jehyunghan0777-lab/motion-aware-hr-monitor/hardware/images/example.jpg

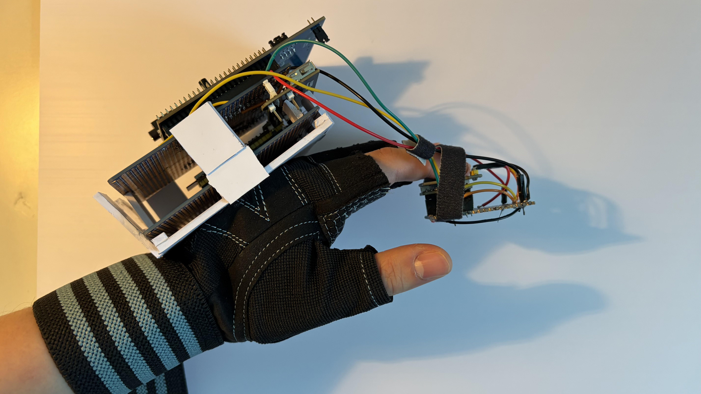
hardware/images/example.jpg
