jehyunghan0777-lab/motion-aware-hr-monitor/hardware/images/first_layer.jpeg

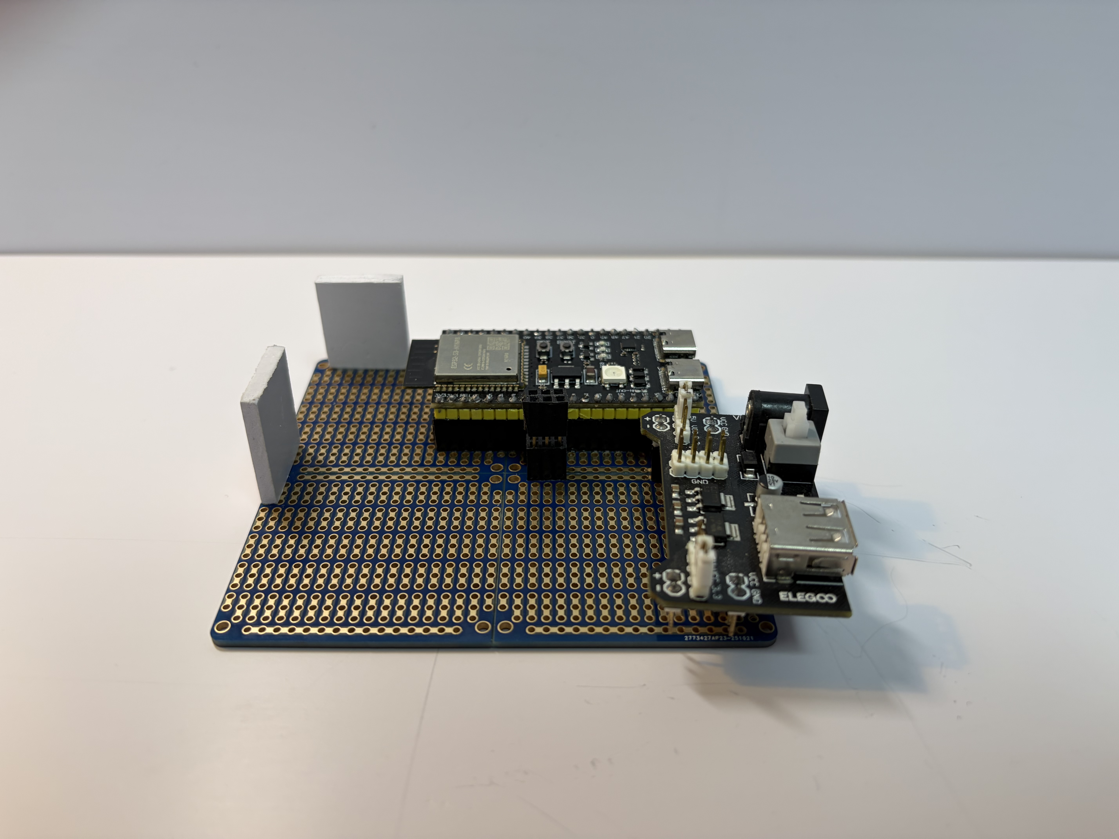
hardware/images/first_layer.jpeg
