jehyunghan0777-lab/motion-aware-hr-monitor/hardware/images/glove_based_platform.jpeg

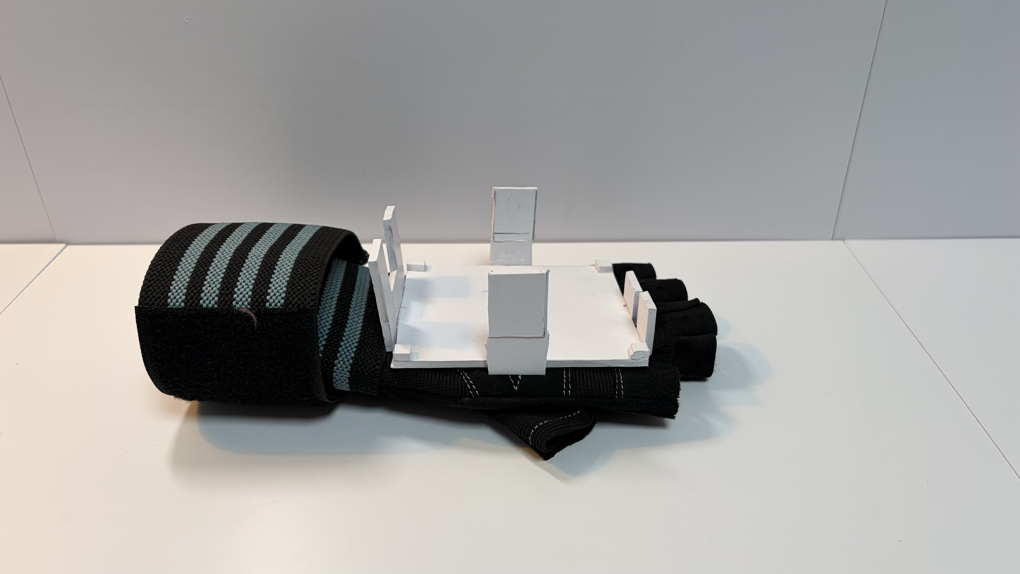
hardware/images/glove_based_platform.jpeg
