jehyunghan0777-lab/motion-aware-hr-monitor/hardware/images/sensors.jpeg

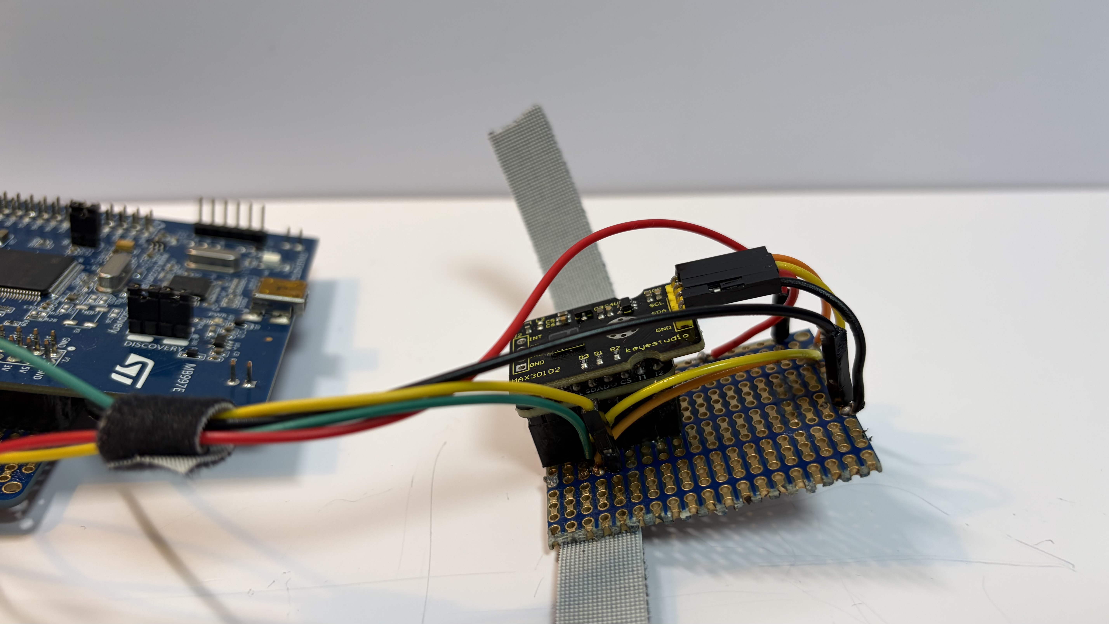
hardware/images/sensors.jpeg
