jehyunghan0777-lab/motion-aware-hr-monitor/hardware/images/two_layers_stacked.jpeg

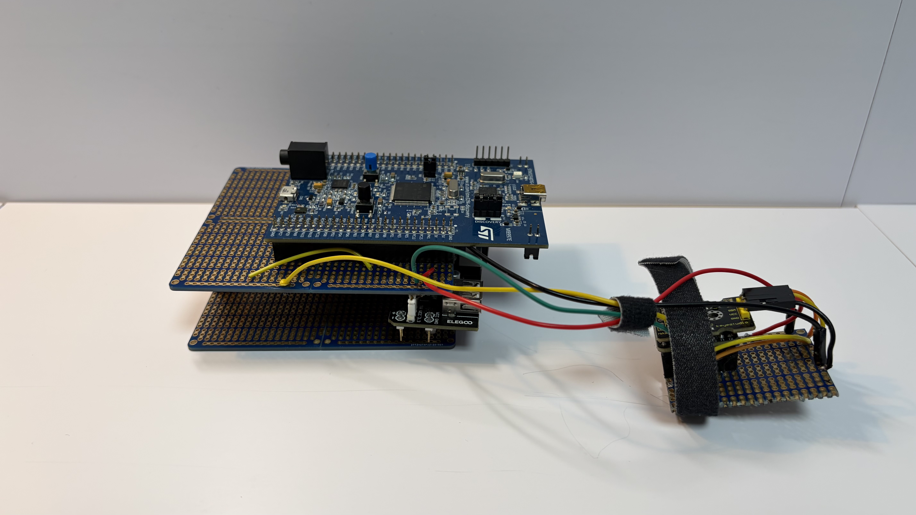
hardware/images/two_layers_stacked.jpeg
