jehyunghan0777-lab/motion-aware-hr-monitor/hardware/schematic/schematic_motion_aware_hr_monitor.png

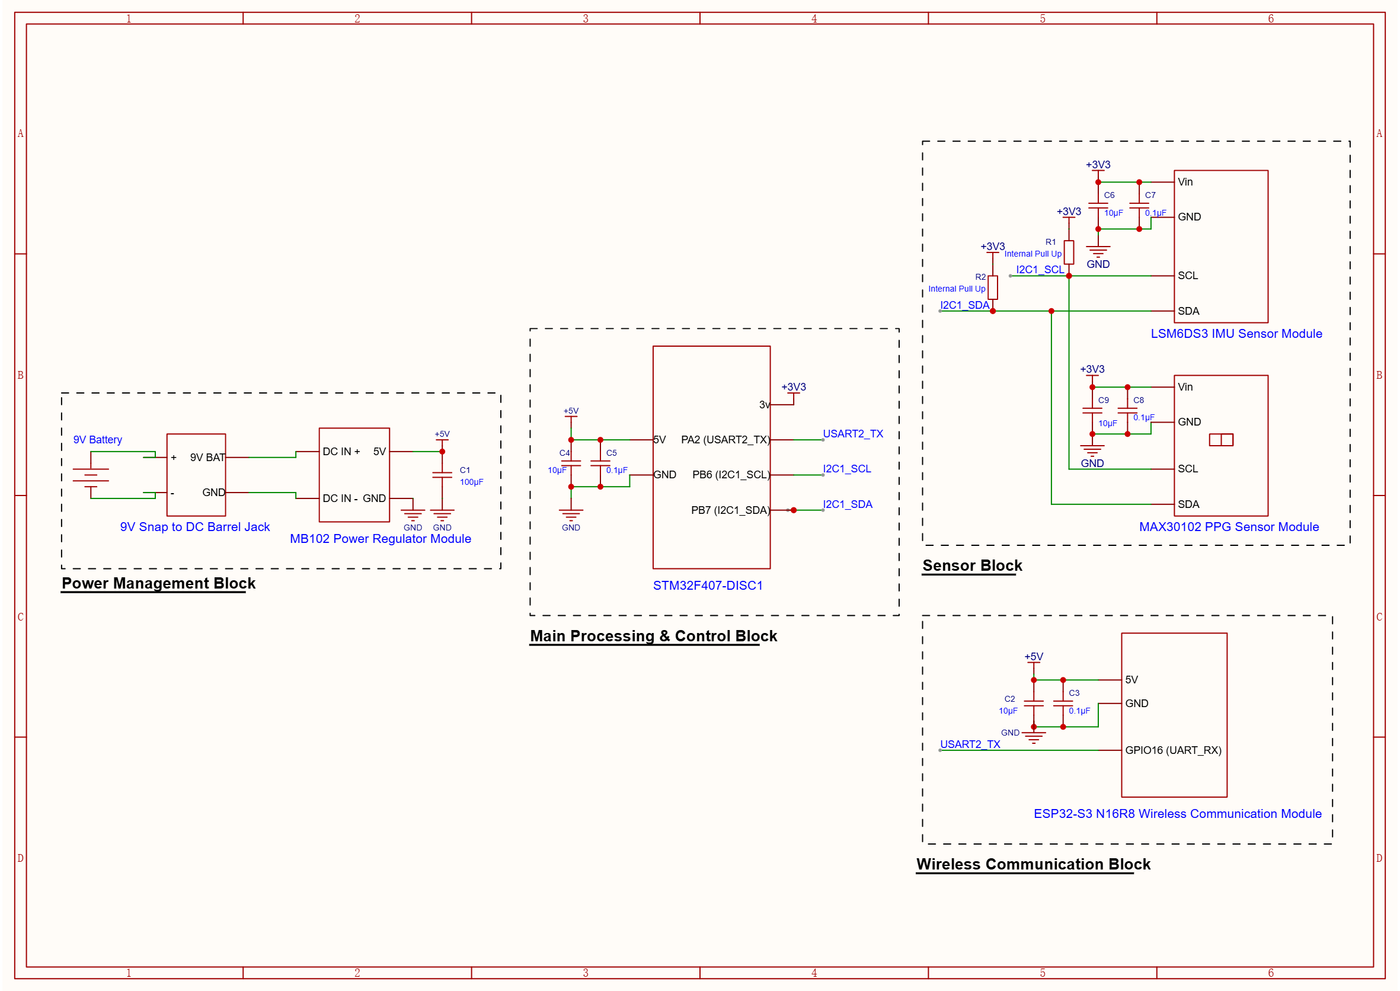
hardware/schematic/schematic_motion_aware_hr_monitor.png
