jehyunghan0777-lab/motion-aware-hr-monitor/data/results/hr_logger_1hz_analysis.xlsx

Sheet: Data
seconds | hr_fft | conf_fft | peak_hz | peak_ratio | k_peaks | hr_final | conf_final | mode | s_motion | s_freq | motion_high | freq_bad | motion | external_hr | error_bpm | abs_error_bpm
0 | 86.000 | 0.710 | 1.444 | 2.340 | 7.000 | 86.000 | 0.550 | FREQ | 0.900 | 0.550 | 1.000 | 0.000 | 1019.500 | 86.000 | 0.000 | 0.000
1 | 85.200 | 0.670 | 1.390 | 2.210 | 7.000 | 85.200 | 0.530 | FREQ | 0.900 | 0.530 | 1.000 | 0.000 | 1012.500 | 86.000 | -0.800 | 0.800
2 | 82.100 | 0.410 | 1.270 | 1.830 | 7.000 | 82.100 | 0.410 | FREQ | 0.920 | 0.410 | 1.000 | 0.000 | 768.200 | 86.000 | -3.900 | 3.900
3 | 82.100 | 0.670 | 1.272 | 2.190 | 7.000 | 82.100 | 0.620 | FREQ | 0.890 | 0.620 | 1.000 | 0.000 | 1103.000 | 86.000 | -3.900 | 3.900
4 | 80.100 | 0.690 | 1.297 | 2.260 | 7.000 | 80.100 | 0.690 | FREQ | 0.920 | 0.690 | 1.000 | 0.000 | 787.600 | 86.000 | -5.900 | 5.900
5 | 79.400 | 0.720 | 1.307 | 2.380 | 7.000 | 79.400 | 0.720 | FREQ | 0.910 | 0.720 | 1.000 | 0.000 | 940.300 | 82.000 | -2.600 | 2.600
6 | 78.500 | 0.740 | 1.283 | 2.440 | 7.000 | 78.500 | 0.730 | FREQ | 0.920 | 0.730 | 1.000 | 0.000 | 812.600 | 82.000 | -3.500 | 3.500
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
