jehyunghan0777-lab/motion-aware-hr-monitor/data/results/hr_logger_2hz_analysis.xlsx

Sheet: Data
seconds | hr_fft | conf_fft | peak_hz | peak_ratio | k_peaks | hr_final | conf_final | mode | s_motion | s_freq | motion_high | freq_bad | motion | external_hr | error_bpm | abs_error_bpm
0.000 | 78.000 | 0.780 | 1.351 | 2.560 | 7.000 | 78.000 | 0.540 | FREQ | 0.270 | 0.540 | 1.000 | 0.000 | 7265.200 | 81.000 | -3.000 | 3.000
1.000 | 79.300 | 0.860 | 1.351 | 2.820 | 7.000 | 79.300 | 0.600 | FREQ | 0.240 | 0.600 | 1.000 | 0.000 | 7588.400 | 81.000 | -1.700 | 1.700
2.000 | 80.000 | 0.930 | 1.346 | 3.060 | 7.000 | 80.000 | 0.680 | FREQ | 0.280 | 0.680 | 1.000 | 0.000 | 7230.400 | 81.000 | -1.000 | 1.000
3.000 | 80.300 | 0.910 | 1.343 | 3.010 | 7.000 | 80.300 | 0.690 | FREQ | 0.330 | 0.690 | 1.000 | 0.000 | 6741.400 | 81.000 | -0.700 | 0.700
4.000 | 80.300 | 0.810 | 1.341 | 2.660 | 7.000 | 80.300 | 0.590 | FREQ | 0.220 | 0.590 | 1.000 | 0.000 | 7790.100 | 81.000 | -0.700 | 0.700
5.000 | 80.700 | 0.800 | 1.355 | 2.620 | 7.000 | 80.700 | 0.790 | FREQ | 0.270 | 0.790 | 1.000 | 0.000 | 7285.800 | 84.000 | -3.300 | 3.300
6.000 | 81.800 | 0.770 | 1.396 | 2.550 | 7.000 | 81.800 | 0.740 | FREQ | 0.170 | 0.740 | 1.000 | 0.000 | 8304.100 | 84.000 | -2.200 | 2.200
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
