jehyunghan0777-lab/motion-aware-hr-monitor/data/results/hr_logger_3hz_analysis.xlsx

Sheet: Data
seconds | hr_fft | conf_fft | peak_hz | peak_ratio | k_peaks | hr_final | conf_final | mode | s_motion | s_freq | motion_high | freq_bad | motion | external_hr | error_bpm | abs_error_bpm
0.000 | 82.300 | 0.730 | 1.381 | 2.410 | 7.000 | 82.300 | 0.730 | FREQ | 0.000 | 0.730 | 1.000 | 0.000 | 10140.200 | 83.000 | -0.700 | 0.700
1.000 | 82.700 | 0.800 | 1.390 | 2.640 | 7.000 | 82.700 | 0.690 | FREQ | 0.040 | 0.690 | 1.000 | 0.000 | 9577.400 | 83.000 | -0.300 | 0.300
2.000 | 83.700 | 0.780 | 1.425 | 2.560 | 7.000 | 83.700 | 0.680 | FREQ | 0.000 | 0.680 | 1.000 | 0.000 | 10208.400 | 85.000 | -1.300 | 1.300
3.000 | 85.000 | 0.820 | 1.450 | 2.710 | 7.000 | 85.000 | 0.790 | FREQ | 0.010 | 0.790 | 1.000 | 0.000 | 9897.100 | 85.000 | 0.000 | 0.000
4.000 | 86.200 | 0.540 | 1.465 | 2.250 | 7.000 | 86.200 | 0.510 | FREQ | 0.180 | 0.510 | 1.000 | 0.000 | 8232.600 | 86.000 | 0.200 | 0.200
5.000 | 86.600 | 0.400 | 1.465 | 1.800 | 7.000 | 86.600 | 0.330 | FREQ | 0.180 | 0.330 | 1.000 | 0.000 | 8219.400 | 86.000 | 0.600 | 0.600
6.000 | 86.600 | 0.380 | 1.465 | 1.730 | 7.000 | 86.600 | 0.320 | FREQ | 0.130 | 0.320 | 1.000 | 0.000 | 8705.800 | 88.000 | -1.400 | 1.400
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
