jehyunghan0777-lab/motion-aware-hr-monitor/data/results/hr_logger_no_motion_analysis.xlsx

Sheet: Data
seconds | hr_fft | conf_fft | peak_hz | peak_ratio | k_peaks | hr_final | conf_final | mode | s_motion | s_freq | motion_high | freq_bad | motion | external_hr | error_bpm | abs_error_bpm
0 | 88.7 | 0.9 | 1.525 | 2.97 | 8 | 88.7 | 0.89 | FREQ | 0.98 | 0.89 | 0 | 0 | 154.1 | 90 | -1.3 | 1.3
1 | 90.4 | 0.94 | 1.546 | 3.08 | 8 | 90.4 | 0.91 | FREQ | 0.98 | 0.91 | 0 | 0 | 154.3 | 90 | 0.4 | 0.4
2 | 91.7 | 0.97 | 1.559 | 3.21 | 8 | 91.7 | 0.96 | FREQ | 0.98 | 0.96 | 0 | 0 | 231.4 | 92 | -0.3 | 0.3
3 | 92.3 | 1 | 1.549 | 3.29 | 8 | 92.3 | 1 | FREQ | 0.97 | 1 | 0 | 0 | 283.2 | 92 | 0.3 | 0.3
4 | 92.4 | 1 | 1.54 | 3.41 | 8 | 92.4 | 1 | FREQ | 0.97 | 1 | 0 | 0 | 311.4 | 93 | -0.6 | 0.6
5 | 92.6 | 1 | 1.553 | 3.52 | 8 | 92.6 | 0.94 | FREQ | 0.97 | 0.94 | 0 | 0 | 289 | 93 | -0.4 | 0.4
6 | 93.2 | 1 | 1.57 | 3.4 | 8 | 93.2 | 0.99 | FREQ | 0.97 | 0.99 | 0 | 0 | 338 | 93 | 0.2 | 0.2
7 | 93.4 | 0.94 | 1.558 | 3.1 | 8 | 93.4 | 0.92 | FREQ | 0.96 | 0.92 | 0 | 0 | 447.4 | 93 | 0.4 | 0.4
8 | 92.9 | 0.92 | 1.532 | 3.05 | 8 | 92.9 | 0.9 | FREQ | 0.95 | 0.9 | 0 | 0 | 516.2 | 93 | -0.1 | 0.1
9 | 92 | 0.9 | 1.51 | 2.95 | 8 | 92 | 0.86 | FREQ | 0.96 | 0.86 | 0 | 0 | 406.9 | 93 | -1 | 1
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
