jehyunghan0777-lab/motion-aware-hr-monitor/media/results/final_hr_vs_ref_hr/2Hz_final_hr_vs_external.png

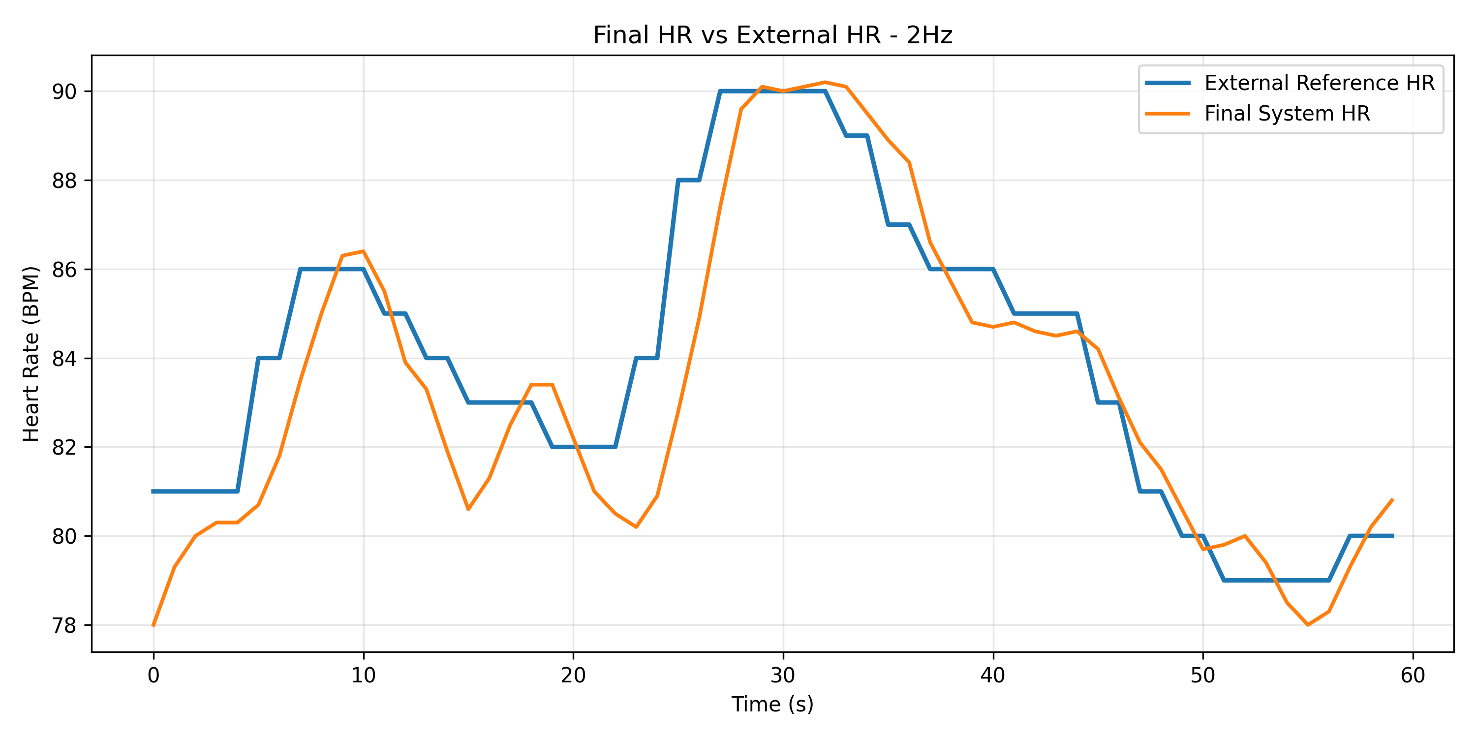
media/results/final_hr_vs_ref_hr/2Hz_final_hr_vs_external.png
