jehyunghan0777-lab/motion-aware-hr-monitor/media/results/hr_decision_layer_performance/3hz_fft_vs_final_time_plot_with_hold.png

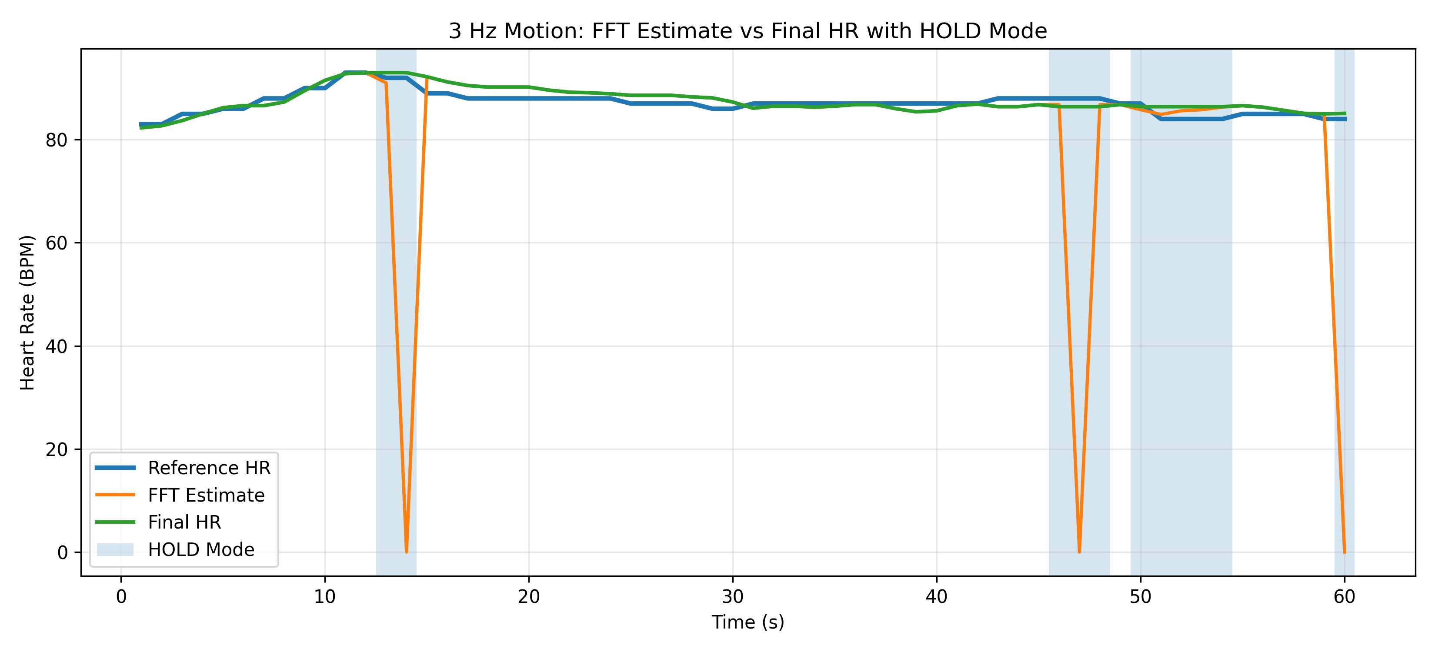
media/results/hr_decision_layer_performance/3hz_fft_vs_final_time_plot_with_hold.png
