jehyunghan0777-lab/motion-aware-hr-monitor/media/results/nlms_anc_performance/2Hz_error_metrics_bar_chart.png

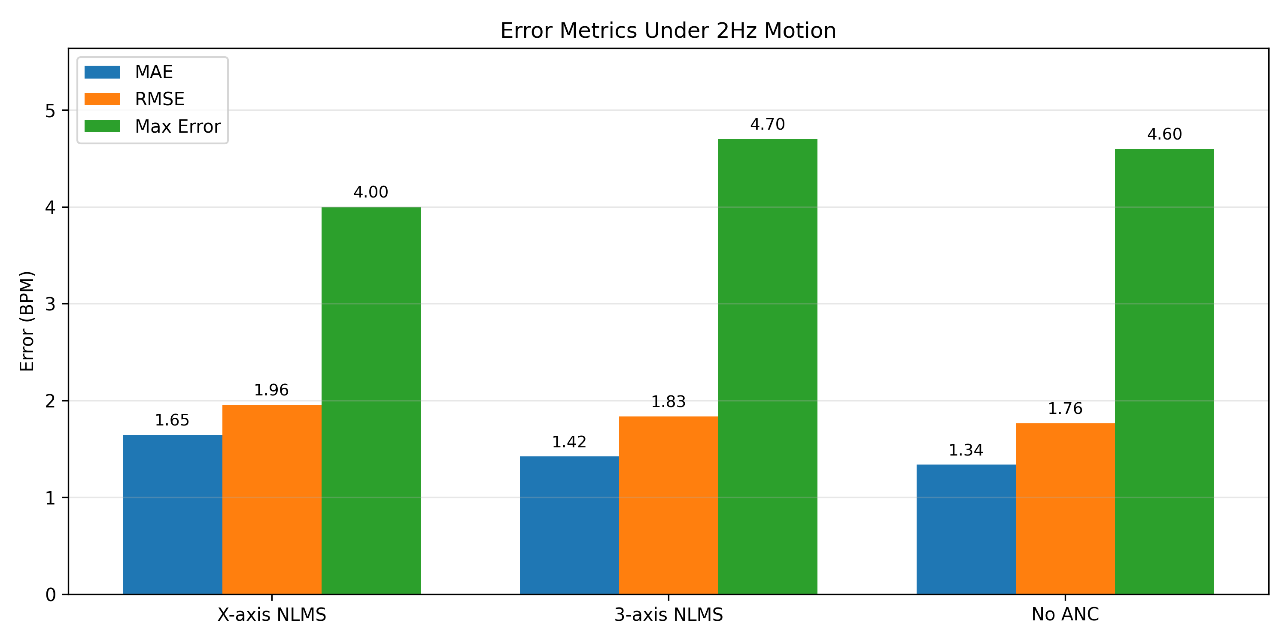
media/results/nlms_anc_performance/2Hz_error_metrics_bar_chart.png
