jehyunghan0777-lab/motion-aware-hr-monitor/media/results/nlms_anc_performance/2Hz_hr_time_plot.png

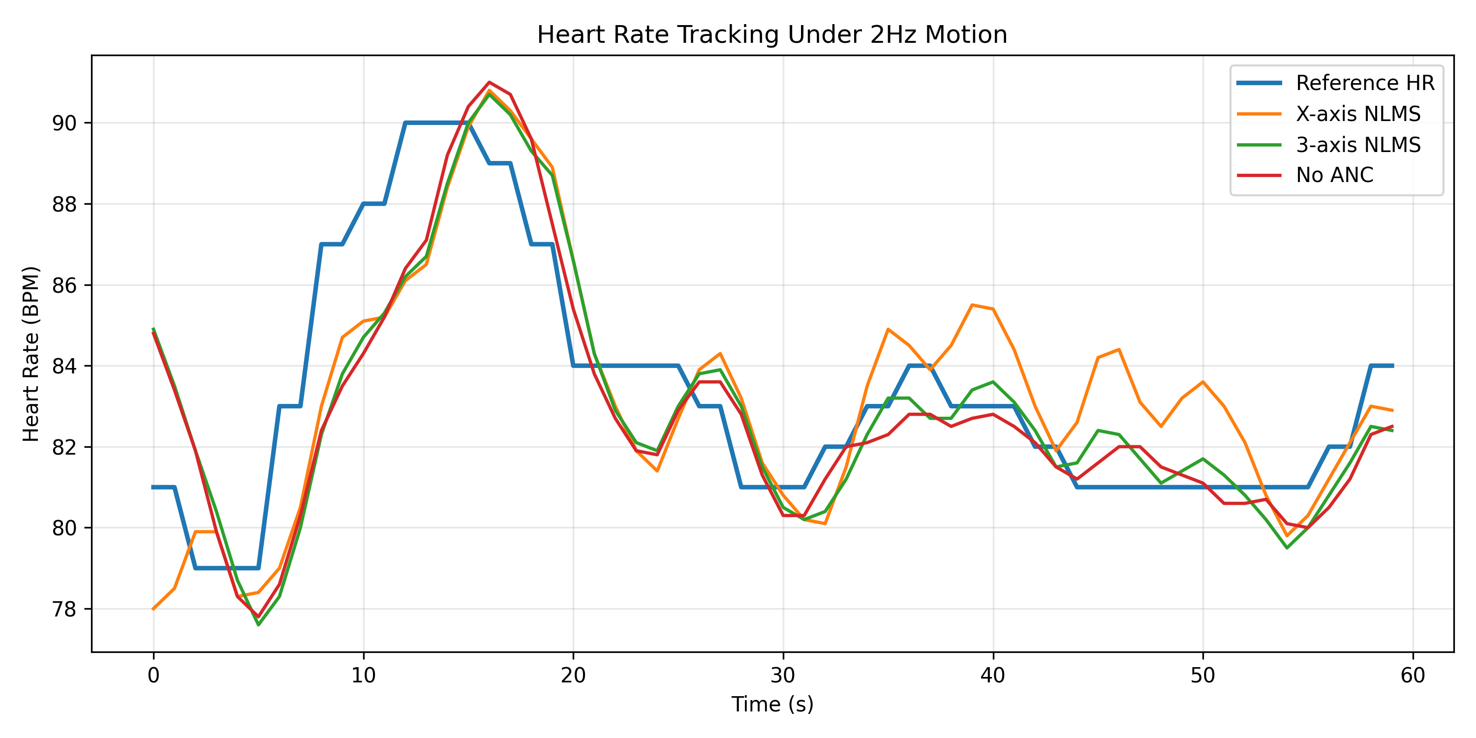
media/results/nlms_anc_performance/2Hz_hr_time_plot.png
