jehyunghan0777-lab/motion-aware-hr-monitor/firmware/stm32/Core/Src/main.c

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
/* Includes ------------------------------------------------------------------*/
#include "main.h"

/* USER CODE BEGIN Includes */
#include <stdint.h>
#include <string.h>
#include <stdio.h>
#include <math.h>

#include "lsm6ds3.h"
#include "max30102.h"
#include "blockc_data_preprocessing.h"
#include "blockd_motion_metric.h"
#include "blocke_nlms_anc.h"
#include "blockf_hr_estimation.h"
#include "blockg_sqi.h"
#include "blockh_decision_update.h"

/* USER CODE END Includes */

/* USER CODE BEGIN PTD */

//Sample acquisition state-machine
typedef enum
{
	ACQ_IDLE = 0,
	ACQ_READ_PPG,
	ACQ_READ_IMU,
	ACQ_COMMIT
} acq_state_t;

//States for valid & invalid samples in case of failure reading
typedef enum
{
	SAMPLE_VALID = 0,
	SAMPLE_INVALID = 1
} sample_status_t;


/* USER CODE END PTD */

/* USER CODE BEGIN PD */
#define RB_SIZE				         1024U

#define MAX_PENDING_ACQ              2U
#define MAX_CONSEC_FAILS             5U

#define UART_LOG_TIMEOUT_MS          50U
#define RECOVERY_RETRY_INTERVAL_MS   1000U


/* USER CODE END PD */

I2C_HandleTypeDef hi2c1;

I2S_HandleTypeDef hi2s3;

SPI_HandleTypeDef hspi1;

TIM_HandleTypeDef htim2;

UART_HandleTypeDef huart2;

/* USER CODE BEGIN PV */

/* ---------------- Shared scheduler variables ---------------- */
//GLOBAL VARIABLES for TIM2. It updates once the TIM2 increments
//and sets flag once interrupt occurs.
volatile uint32_t sample_idx = 0;      //global sampple index incremented every timer count
volatile uint32_t acquire_pending = 0; //pending acquire request


/* ---------------- Logical acquisition indexing ---------------- */
static uint32_t started_sample_idx = 0;
static uint32_t acq_sample_idx = 0; //latched index for current acquisiton cycle
static uint32_t commited_sample_idx = 0;

static uint32_t failed_acq_cnt = 0;

//For printing
uint32_t last_written_idx = 0;
uint8_t rb_has_data = 0;

//Acquisition state will first be idle and later be updated through the acquisition layer
static acq_state_t acq_state = ACQ_IDLE;

/* ---------------- Temporary sample staging ---------------- */
//For now, we will keep them as 32 and 16 bits respectively, but later might change.
static uint32_t ppg_ir_raw = 0;
static uint32_t ppg_red_raw = 0;

static int16_t imu_ax_raw = 0;
static int16_t imu_ay_raw = 0;
static int16_t imu_az_raw = 0;

/* ---------------- Ring buffers ---------------- */
uint32_t ppg_ir_rb[RB_SIZE];
static uint32_t ppg_red_rb[RB_SIZE];

int16_t imu_ax_rb[RB_SIZE];
int16_t imu_ay_rb[RB_SIZE];
int16_t imu_az_rb[RB_SIZE];

float imu_mag_rb[RB_SIZE];

uint32_t idx_rb[RB_SIZE];

sample_status_t sample_status_rb[RB_SIZE];

/* ---------------- Recovery ---------------- */
static uint32_t dropped_tick_cnt = 0;
static uint32_t consecutive_fail_cnt = 0;

static uint8_t acquisition_blocked = 0;
static uint32_t last_recovery_attempt_ms = 0;

/* USER CODE END PV */

void SystemClock_Config(void);
static void MX_GPIO_Init(void);
static void MX_I2C1_Init(void);
static void MX_I2S3_Init(void);
static void MX_SPI1_Init(void);
static void MX_TIM2_Init(void);
static void MX_USART2_UART_Init(void);
/* USER CODE BEGIN PFP */

/* ---------------- Function prototypes ---------------- */

static void BlockA_Acquire_Task(void);

static HAL_StatusTypeDef MAX_Read_Sample_Blocking(uint32_t *ir, uint32_t *red);
static HAL_StatusTypeDef LSM_Read_Sample_Blocking(int16_t *ax, int16_t *ay, int16_t *az);

static void Commit_Aligned_Sample(uint32_t idx, uint32_t ir,
		uint32_t red, int16_t ax, int16_t ay, int16_t az);

//Failure Function
static void Commit_Failed_Sample(uint32_t idx);

//Helper wrapper function for UART Logging
static void uart_log (const char *msg) {
	HAL_UART_Transmit(&huart2, (uint8_t *)msg, strlen(msg), UART_LOG_TIMEOUT_MS);
}

//Function for calculating IMU magnitude
static float imu_mag_approx(int16_t ax, int16_t ay, int16_t az);

//Function for recovering I2C Bus
static void Recover_I2C_Bus(void);

//Function for recovering I2C Bus & Sensors
static HAL_StatusTypeDef Recover_I2C_And_Sensors(void);

/* USER CODE END PFP */

/**
  * @brief  The application entry point.
  * @retval int
  */
int main(void)
{

  /* MCU Configuration--------------------------------------------------------*/

  /* Reset of all peripherals, Initializes the Flash interface and the Systick. */
  HAL_Init();

  /* Configure the system clock */
  SystemClock_Config();

  /* Initialize all configured peripherals */
  MX_GPIO_Init();
  MX_I2C1_Init();
  MX_I2S3_Init();
  MX_SPI1_Init();
  MX_TIM2_Init();
  MX_USART2_UART_Init();
  /* USER CODE BEGIN 2 */

  //Buffer for UART logging
  char msg[512];


  //For storing the part ID value
  uint8_t part_id = 0;

  uart_log("\r\n Program Begins...\r\n");
  uart_log("Start scanning for PART ID & Initializing Sensors...\r\n");

  //PART ID Scan and Initialization for MAX30102
  if(max30102_read_who_am_i(&hi2c1, &part_id) != HAL_OK){
	  uart_log("MAX30102 Failed Recognizing Part ID\r\n");
	  while(1);
  }

  snprintf(msg, sizeof(msg), "MAX30102 WHO AM I: 0x%02x\r\n", part_id);
  uart_log(msg);

  if(part_id != 0x15){
	  uart_log("MAX30102 Wrong Part ID Recognized.\r\n");
	  while(1);
  }

  if(max30102_init(&hi2c1) != HAL_OK){
	  uart_log("MAX30102 Initialization Failed!\r\n");
	  while(1);
  }

  uart_log("MAX30102 Initialization Complete!\r\n");


  //PART ID Scan and Initialization for LSM6DS3
  if(lsm6ds3_read_who_am_i(&hi2c1, &part_id) != HAL_OK){
	  uart_log("LSM6DS3 Failed Recognizing Part ID\r\n");
	  while(1);
  }

  snprintf(msg, sizeof(msg), "LSM6DS3 WHO AM I: 0x%02x\r\n", part_id);
  uart_log(msg);

  if(part_id != 0x6A){
	  uart_log("LSM6DS3 Wrong Part ID Recognized.\r\n");
	  while(1);
  }

  if(lsm6ds3_init(&hi2c1) != HAL_OK) {
	  uart_log("LSM6DS3 Initialization Failed!\r\n");
	  while(1);
  }


  uart_log("LSM6DS3 Initialization Complete!\r\n");

  //Start the timer.
  HAL_TIM_Base_Start_IT(&htim2);

  uart_log("I2C Scan Complete! \r\n");
  uint32_t last_printed = 0;


  /* USER CODE END 2 */

  /* Infinite loop */
  /* USER CODE BEGIN WHILE */
  while (1)
  {

	  BlockA_Acquire_Task();
	  BlockC_Data_Preprocessing();
	  BlockD_Motion_Metric();
	  BlockE_NLMS_ANC();
	  BlockF_HR_Estimation();
	  BlockG_SQI_Update();
	  BlockH_Decision_Update();

	  if(HAL_GetTick() - last_printed >= 1000) {

		  last_printed = HAL_GetTick();

		  if(rb_has_data) {

			  snprintf(msg, sizeof(msg),
			      "%.1f,%.2f,%lu,%.4f,"
			      "%.1f,%.2f,%.3f,%.2f,%lu,"
			      "%.1f,%.2f,%d,"
			      "%.2f,%.2f,%.2f,%u,%u,%u,"
			      "%.1f\r\n",

			      hr_time_result.hr_bpm,
			      hr_time_result.conf,
			      hr_time_result.n_peaks,
			      hr_time_result.ibi_var,

			      hr_fft_result.hr_bpm,
			      hr_fft_result.conf,
			      hr_fft_result.peak_hz,
			      hr_fft_result.peak_ratio,
			      hr_fft_result.k_peaks,

			      hr_final_result.hr_bpm,
			      hr_final_result.conf,
			      hr_final_result.mode,

			      sqi_result.s_motion,
			      sqi_result.s_time,
			      sqi_result.s_freq,
			      motion_state,
			      sqi_result.time_bad,
			      sqi_result.freq_bad,

			      latest_m
			  );

			  uart_log(msg);

		  }//end if2
	  }//end if1


    /* USER CODE END WHILE */

    /* USER CODE BEGIN 3 */
  }
  /* USER CODE END 3 */
}

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
/* USER CODE BEGIN 4 */

/* ---------------- Callback function ---------------- */
void HAL_TIM_PeriodElapsedCallback(TIM_HandleTypeDef *htim)
{
    if (htim->Instance == TIM2)
    {
        sample_idx++;

        if(acquire_pending < MAX_PENDING_ACQ) {

        acquire_pending++;

        }
        else {
        	dropped_tick_cnt++;
        }

    }
}

/* ---------------- Block A for sample acquisition ---------------- */
static void BlockA_Acquire_Task(void) {

	if(acquisition_blocked){

		if(HAL_GetTick() - last_recovery_attempt_ms >= RECOVERY_RETRY_INTERVAL_MS){

			last_recovery_attempt_ms = HAL_GetTick();

			if(Recover_I2C_And_Sensors() == HAL_OK){

				acquisition_blocked = 0;

			}
		}

		return;

	}


	switch(acq_state) {

	case ACQ_IDLE:
	{
		uint8_t start_acq = 0;

		__disable_irq();
		if(acquire_pending > 0) {

			acquire_pending--;
			start_acq = 1;


		}//End if

		__enable_irq();

		if(start_acq){
			//Assign one logical sample index to this entire acquisition cycle
			started_sample_idx++;
			acq_sample_idx = started_sample_idx;

			acq_state = ACQ_READ_PPG;
		}

		break;
	}//End case

	case ACQ_READ_PPG:
	{
		if(MAX_Read_Sample_Blocking(&ppg_ir_raw, &ppg_red_raw) == HAL_OK) {

			acq_state = ACQ_READ_IMU;

		}//End if
		else {

			Commit_Failed_Sample(acq_sample_idx);
			consecutive_fail_cnt++;

			if(consecutive_fail_cnt >= MAX_CONSEC_FAILS){

				if(Recover_I2C_And_Sensors() != HAL_OK) {
					acquisition_blocked = 1;
					last_recovery_attempt_ms = HAL_GetTick();
					acq_state = ACQ_IDLE;
				}
			}
			else {
				acq_state = ACQ_IDLE;
			}

		}//End else
		break;
	}//End case

	case ACQ_READ_IMU:
	{

		if(LSM_Read_Sample_Blocking(&imu_ax_raw, &imu_ay_raw, &imu_az_raw) == HAL_OK) {

			acq_state = ACQ_COMMIT;

		}//End if
		else {

			Commit_Failed_Sample(acq_sample_idx);
			consecutive_fail_cnt++;

			if(consecutive_fail_cnt >= MAX_CONSEC_FAILS){

				if(Recover_I2C_And_Sensors() != HAL_OK) {
					acquisition_blocked = 1;
					last_recovery_attempt_ms = HAL_GetTick();
					acq_state = ACQ_IDLE;
				}
			}
			else {
				acq_state = ACQ_IDLE;
			}

		}//End else
		break;
	}//End case

	case ACQ_COMMIT:
	{

		Commit_Aligned_Sample(acq_sample_idx, ppg_ir_raw, ppg_red_raw,imu_ax_raw,
				imu_ay_raw, imu_az_raw);

		consecutive_fail_cnt = 0;
		acq_state = ACQ_IDLE;

		break;
	}//End case

	default:
	{
		acq_state = ACQ_IDLE;
		break;
	}//End default

	}//End switch

}//End function

/* ---------------- Functions for acquiring samples ---------------- */
static HAL_StatusTypeDef MAX_Read_Sample_Blocking(uint32_t *ir, uint32_t *red){

	max30102_sample_t ppg;
	HAL_StatusTypeDef st;

	if(ir == NULL || red == NULL) {
		return HAL_ERROR;
	}

	st = max30102_read_fifo(&hi2c1, &ppg);
	if(st != HAL_OK){
		return st;
	}

	*red = ppg.red;
	*ir = ppg.ir;

	return HAL_OK;
}
static HAL_StatusTypeDef LSM_Read_Sample_Blocking(int16_t *ax, int16_t *ay, int16_t *az){

	 lsm6ds3_vec3_raw_t acc;
	 HAL_StatusTypeDef st;

	 if(ax == NULL || ay == NULL || az == NULL){
		 return HAL_ERROR;
	 }

	 st = lsm6ds3_read_raw_acc(&hi2c1, &acc);
	 if(st != HAL_OK) {
		 return st;
	 }

	*ax = acc.x;
	*ay = acc.y;
	*az = acc.z;

	return HAL_OK;
}


static void Commit_Aligned_Sample(uint32_t idx, uint32_t ir,
		uint32_t red, int16_t ax, int16_t ay, int16_t az) {

	//For creating a ring buffer index that wraps around at RB_SIZE
	uint32_t w = idx % RB_SIZE;

	//Storing the data to the ring buffers with a corresponding index w in the order of
	//ppg, imu, and idx, respectively.
	ppg_red_rb[w] = red;
	ppg_ir_rb[w] = ir;

	imu_ax_rb[w] = ax;
	imu_ay_rb[w] = ay;
	imu_az_rb[w] = az;

	//Storing IMU MAG into ring buffer
	imu_mag_rb[w] = imu_mag_approx(ax, ay, az);

	idx_rb[w] = idx;

	last_written_idx = idx;
	rb_has_data = 1;

//For storing sample status
	sample_status_rb[w] = SAMPLE_VALID;

	commited_sample_idx++;
}

static void Commit_Failed_Sample(uint32_t idx) {

	uint32_t w = idx % RB_SIZE;

	idx_rb[w] = idx;

	//Stores "0" when data is invalid.
	ppg_red_rb[w] = 0;
	ppg_ir_rb[w] = 0;

	imu_ax_rb[w] = 0;
	imu_ay_rb[w] = 0;
	imu_az_rb[w] = 0;

	imu_mag_rb[w] = 0.0f;

	last_written_idx = idx;
	rb_has_data = 1;

	sample_status_rb[w] = SAMPLE_INVALID;

	failed_acq_cnt ++;
}

/* ---------------- Block B for IMU magnitude approximation ---------------- */

static float imu_mag_approx(int16_t ax, int16_t ay, int16_t az){

	return fabsf(ax) + fabsf(ay) + fabsf(az);

}

/* ---------------- Functions for I2C Recovery during failure ---------------- */

static void Recover_I2C_Bus(void){

	GPIO_InitTypeDef GPIO_InitStruct = {0};

	HAL_I2C_DeInit(&hi2c1);

	__HAL_RCC_I2C1_FORCE_RESET();
	HAL_Delay(1);
	__HAL_RCC_I2C1_RELEASE_RESET();
	HAL_Delay(1);

	__HAL_RCC_GPIOB_CLK_ENABLE();

	GPIO_InitStruct.Pin = GPIO_PIN_6 | GPIO_PIN_7;
	GPIO_InitStruct.Mode = GPIO_MODE_OUTPUT_OD;
	GPIO_InitStruct.Pull = GPIO_PULLUP;
	GPIO_InitStruct.Speed = GPIO_SPEED_FREQ_HIGH;
	HAL_GPIO_Init(GPIOB, &GPIO_InitStruct);

	HAL_GPIO_WritePin(GPIOB, GPIO_PIN_6, GPIO_PIN_SET);
	HAL_GPIO_WritePin(GPIOB, GPIO_PIN_7, GPIO_PIN_SET);
	HAL_Delay(1);

	for(int i = 0; i < 9; i++){

		HAL_GPIO_WritePin(GPIOB, GPIO_PIN_6, GPIO_PIN_RESET);
		HAL_Delay(1);
		HAL_GPIO_WritePin(GPIOB, GPIO_PIN_6, GPIO_PIN_SET);
		HAL_Delay(1);
	}

	HAL_GPIO_WritePin(GPIOB, GPIO_PIN_7, GPIO_PIN_RESET);
	HAL_Delay(1);
	HAL_GPIO_WritePin(GPIOB, GPIO_PIN_6, GPIO_PIN_SET);
	HAL_Delay(1);
	HAL_GPIO_WritePin(GPIOB, GPIO_PIN_7, GPIO_PIN_SET);
	HAL_Delay(1);

	GPIO_PinState scl = HAL_GPIO_ReadPin(GPIOB, GPIO_PIN_6);
	GPIO_PinState sda = HAL_GPIO_ReadPin(GPIOB, GPIO_PIN_7);

	if(scl == GPIO_PIN_RESET || sda == GPIO_PIN_RESET) {
		uart_log("I2C Bus still low after recovery! \r\n");
	}


	GPIO_InitStruct.Pin = GPIO_PIN_6 | GPIO_PIN_7;
	GPIO_InitStruct.Mode = GPIO_MODE_AF_OD;
	GPIO_InitStruct.Pull = GPIO_NOPULL;
	GPIO_InitStruct.Speed = GPIO_SPEED_FREQ_HIGH;
	GPIO_InitStruct.Alternate = GPIO_AF4_I2C1;
	HAL_GPIO_Init(GPIOB, &GPIO_InitStruct);

	MX_I2C1_Init();
}

static HAL_StatusTypeDef Recover_I2C_And_Sensors(void){

	uint8_t part_id = 0;

	char msg[256];

	HAL_TIM_Base_Stop_IT(&htim2);

	Recover_I2C_Bus();

	HAL_Delay(100);

	HAL_StatusTypeDef st;

	st = max30102_read_who_am_i(&hi2c1, &part_id);

	snprintf(msg, sizeof(msg), "MAXREC st:%d, id:0x%02x, err:0x%08lx, state:%d\r\n",
			st, part_id, HAL_I2C_GetError(&hi2c1), HAL_I2C_GetState(&hi2c1));
	uart_log(msg);

	if(st != HAL_OK || part_id != 0x15){
		uart_log("MAX30102 not present during Recovery!\r\n");
		acquire_pending = 0;
		acq_state = ACQ_IDLE;
		consecutive_fail_cnt = 0;
		acquisition_blocked = 1;
		return HAL_ERROR;
	}

	HAL_Delay(200);

	if(max30102_init(&hi2c1) != HAL_OK) {
		uart_log("MAX30102 Reinit failed!\r\n");
		acquire_pending = 0;
		acq_state = ACQ_IDLE;
		consecutive_fail_cnt = 0;
		acquisition_blocked = 1;
		return HAL_ERROR;
	}

	if(lsm6ds3_read_who_am_i(&hi2c1, &part_id) != HAL_OK || part_id != 0x6A){
		uart_log("LSM6DS3 not present during Recovery!\r\n");
		acquire_pending = 0;
		acq_state = ACQ_IDLE;
		consecutive_fail_cnt = 0;
		acquisition_blocked = 1;
		return HAL_ERROR;
	}

	HAL_Delay(200);

	if(lsm6ds3_init(&hi2c1) != HAL_OK) {
		uart_log("LSM6DS3 Reinit failed!\r\n");
		acquire_pending = 0;
		acq_state = ACQ_IDLE;
		consecutive_fail_cnt = 0;
		acquisition_blocked = 1;
		return HAL_ERROR;
	}

	acquire_pending = 0;
	acq_state = ACQ_IDLE;
	consecutive_fail_cnt = 0;

	__HAL_TIM_SET_COUNTER(&htim2, 0);
	__HAL_TIM_CLEAR_FLAG(&htim2, TIM_FLAG_UPDATE);

	if(HAL_TIM_Base_Start_IT(&htim2) != HAL_OK){
		uart_log("TIM2 Restart Failed!r\n");
		return HAL_ERROR;
	}

	uart_log("I2C & Sensors Recovery Executed!\r\n");

	return HAL_OK;
}


/* USER CODE END 4 */
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
