jehyunghan0777-lab/motion-aware-hr-monitor/(commit log)

2026-06-15 Initial project documentation and repository structure
    [hr_logger_1hz_analysis.xlsx, hr_logger_2hz_analysis.xlsx, hr_logger_3hz_analysis.xlsx, hr_logger_no_motion_analysis.xlsx]
2026-06-15 xlsx files update
    [hr_logger_1hz_analysis.xlsx, hr_logger_2hz_analysis.xlsx, hr_logger_3hz_analysis.xlsx, hr_logger_no_motion_analysis.xlsx]
